dcalde11/EGR314DonDataSheet/docs/index.md

---
title: Welcome
tags:
- tag1
- tag2
---
<center>
<font size= "6">Donovan Calderon Datasheet</font><br>
as part of<br>
<font size= "8"> Submersible Exploration Device </font><br>
for<br>
<font size= "5"> Team 307 </font><br>

**Submission: March, 15, 2026**
</center>

## Introduction
As a member of Team 307, my responsibility was to help 
ensure the team remained on schedule while maintaining a 
professional standard for quality and performance. I 
supported teammates in the development of their modules 
according to project requirements while also assisting in 
prioritizing critical tasks when deadlines approached.

These responsibilities sometimes required difficult 
decisions, including adjusting timelines to preserve the 
integrity of both the project and our work. In addition 
to these leadership duties, my primary technical focus 
was the development of the 3D orientation and positioning 
subsystem.

This page documents my contributions to the electrical 
design, system integration, and performance of the final 
project.

### Project Summary

The concept of a Submersible Exploration Device that the
team came up is to support safe and efficient
underwater exploration through controlled navigation, 
environmental sensing, and real-time system monitoring. 
The overall system integrates pressure and temperature 
sensors for environmental data collection, obstacle
detection for safe movement, and a modular human–machine 
interface that allows operators to monitor system
performance and interact with the device during operation.

My contribution to this project focused on the 
development and integration of the electrical systems 
that support the device’s operation, including the 
implementation of the 3D orientation and positioning 
subsystem. This work involved ensuring reliable 
communication between sensors, microcontrollers, and 
hardware while maintaining stable power distribution 
throughout the system. However my contribution extends 
further into the development of the Navigation system 
using the concept of bevel gears for the mounting of the 
motor controlling the propulsion, as well as the 
developemnt of ALL code across all subsystems.
Below are a few links that highlight my contributions
within the Team Website as well as my Teammates websites 

## Project Links Within Team-Website

- [Sequence Diagram of Team Communication](https://egr-314-team-307-spring-2026.github.io/Team307.github.io/04-Team-Block-Diagram/Team-Diagram/)

- [Chosen Design](https://egr-314-team-307-spring-2026.github.io/Team307.github.io/02-Concept-Design/Design/)

### Direct Links
Here are links across my website that help you navigate 
to specific areas of interest that supported the development 
of my 3D Orientation and Positioning Subsystem.

* To review the details and relationships between the system’s components, refer to the [Block Diagram](https://dcalde11.github.io/EGR314DonDataSheet/02-Block-Diagram/Block-Diagram/).

* To review the system’s components, refer to the [Component Selection](https://dcalde11.github.io/EGR314DonDataSheet/03-Component-Selection/Component-Selection/).

* To review the firmware implementation, refer to the [Microcontroller Code](https://dcalde11.github.io/EGR314DonDataSheet/08-MircoController/MicroController/).

* To review the system communication protocol, refer to the [API Documentation](https://dcalde11.github.io/EGR314DonDataSheet/09-API/API/).

* To review power distribution, refer to the [Power Budget](https://dcalde11.github.io/EGR314DonDataSheet/07-Power%20Budget/powerbudget/).

* To review the cost of components in the subsystem, refer to the [Bill of Materials](https://dcalde11.github.io/EGR314DonDataSheet/04-BOM/BOM/).

* To review the layout of the subsystem, refer to the [Schematic](https://dcalde11.github.io/EGR314DonDataSheet/05-Schematic/schematic/).

* To review the physical PCB layout, refer to the [PCB Design](https://dcalde11.github.io/EGR314DonDataSheet/06-PCB/pcb/).

* To review system requirements, refer to the [Requirements](https://dcalde11.github.io/EGR314DonDataSheet/01-Requirements/Requirements/).

* To review hardware revisions and updates, refer to the [Hardware V2.0](https://dcalde11.github.io/EGR314DonDataSheet/10-Hardware%20V2.0/hardware/).

* To review supporting files and documentation, refer to the [Resources](https://dcalde11.github.io/EGR314DonDataSheet/11-Resources/resources/).

* To review final analysis and project conclusions, refer to the [Reflection](https://dcalde11.github.io/EGR314DonDataSheet/12-Reflection/reflection/).
