dcalde11/EGR314DonDataSheet/docs/10- Hardware V2.0/hardware.md

---
title: Hardware V2.0
tags:
- tag1
- tag2
---
# Hardware V2.0

## Overview
The current Hall Effect Sensor PCB successfully demonstrates the basic functionality including sensor reading, UART communication, and system monitoring using the ESP32-S3. While the 
design works, testing and implementation showed several areas where the hardware could be improved. A Version 2.0 (V2.0) design would focus on making the system more reliable, easier to 
debug, and be better aligned with the original schematic.

## Power System

The current design steps down a +12V input to +5V and +3.3V for the system. While it works, the design could be improved by adding better filtering and protection.

For V2.0:
- Add input protection (reverse polarity protection)
- Improve capacitor placement for cleaner power
- Add more decoupling near sensors and the microcontroller

The changes would reduce electrical noise and improve overall system stability.

## I²C Communication

The original schematic includes two I²C buses, but the current model only uses one.

For V2.0:
- Fully implement both I²C buses
- Ensure proper pull-up resistors are used
- Improve routing of I²C lines on the PCB

Using two buses would make the system more reliable and allow better separation between different sensor functions.

## Sensor Interface

The Hall effect sensor currently works, but it is connected with minimal filtering.

For V2.0:
- Add small filtering components (like capacitors)
- Place components closer to the sensor

This would improve the accuracy and stability of the sensor readings.

## UART Communication

UART is used for communication between systems, but the support is minimal.

For V2.0:
- Add protection on UART lines
- Include a dedicated header for debugging
- Improve accessibility for testing signals

This would make communication more reliable and easier to troubleshoot.

## Servo Support

The PCB includes support for servo control, but the feature was not fully used in the current model.

For V2.0:
- Improve power routing for servo connections
- Add better support for PWM signals
- Separate servo power from logic power if needed

This would allow the system to safely handle higher current loads from motors.

## Debugging Features

The current board includes LEDs for status indication, which are useful during testing.

For V2.0:
- Add more labeled test points
- Improve labeling on the PCB (silkscreen)
- Include easier access to important signals

This would make debugging faster and more efficient.

## PCB Layout

The current PCB works, but the layout can be improved.

For V2.0:
- Improve ground connections
- Clean up routing of signals
- Use wider traces for power lines

Better layout would improve reliability and reduce noise in the system.

## Conclusion

The Version 1.0 design provides a working foundation for the Hall effect sensor system. However, a V2.0 version would improve reliability, signal quality, and usability. By improving the
power system, communication interfaces, and PCB layout, the next version of the hardware would be more robust and easier to use in a complete system.
