dcalde11/EGR314DonDataSheet/docs/05-Schematic/schematic.md

---
title: Module Schematic
---

## Overview

The schematic supports the module’s functionality, power distribution, and 
microcontroller integration. It shows the connections between the major 
components: the AS5600L-ASOM and AS5600-ASOM Hall effect sensors, the ESP32-
S3-WROOM-N4 microcontroller, the TLV73312PDBVR and TPS565242DRLR voltage 
regulators, the 1142 RC servo motors, and the LTST-C190GKT LEDs.

The design ensures:  
- Stable and regulated power delivery  
- Reliable signal conditioning  
- Correct microcontroller interfacing  
- System protection and filtering where required

- **Schematic Image Preview:**  
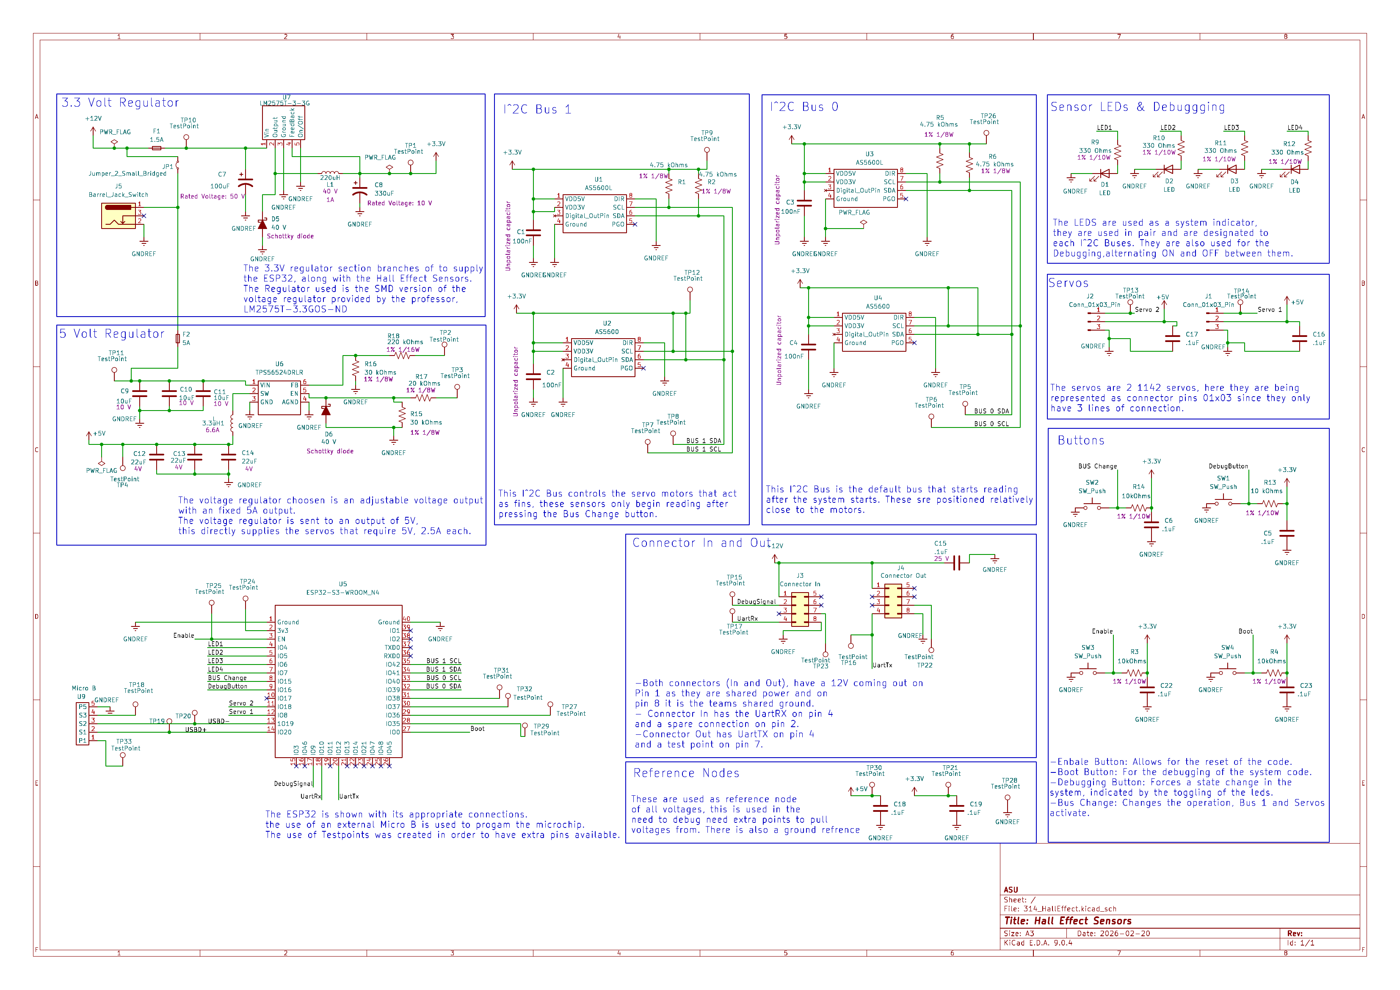
[picture p1: docs/05-Schematic/hall_effect_page_1.png]
Schematic Final
  

**Figure 1:** schematic of the Hall Effect module.

---

## Resources

- **Schematic PDF:** [View 314_HallEffect.pdf](https://github.com/dcalde11/EGR314DonDataSheet/raw/6f55fc1257101241bbe329a0fdce8a7df8599664/docs/05-Schematic/314_HallEffect.pdf)  
- **Complete Project ZIP:** [Download Final314HallEffect.zip](https://github.com/dcalde11/EGR314DonDataSheet/raw/6f55fc1257101241bbe329a0fdce8a7df8599664/docs/05-Schematic/FInal314HallEffect.zip)
