dcalde11/EGR314DonDataSheet/docs/11-Resources/resources.md

---
title: Resources
tags:
- tag1
- tag2
---

# Resources

## Overview

This section contains all supporting files for the project, including firmware, CAD models, and downloadable archives. 

---

## Firmware / Code

**ESP32 / MicroPython Code:**  
  [Download Basic UART Code](https://raw.githubusercontent.com/dcalde11/EGR314DonDataSheet/4a1f67aaadf7519277476e082b6c2123e0716abe/docs/09-API/BasicCodewithUart.py)

---

## CAD / Mechanical Design Files

The following SolidWorks parts and drawings were used in the mechanical design of the system:

- [Body.SLDPRT](https://github.com/dcalde11/EGR314DonDataSheet/blob/a26ca262ecb304e450433a2384b6ee27ddb0144a/docs/11-Resources/Body.SLDPRT)  
- [BodyDrawing.SLDDRW](https://github.com/dcalde11/EGR314DonDataSheet/blob/a26ca262ecb304e450433a2384b6ee27ddb0144a/docs/11-Resources/BodyDrawing.SLDDRW)  
- [Bodyv2sub.SLDPRT](https://github.com/dcalde11/EGR314DonDataSheet/blob/a26ca262ecb304e450433a2384b6ee27ddb0144a/docs/11-Resources/Bodyv2sub.SLDPRT)  
- [HeadFace.SLDPRT](https://github.com/dcalde11/EGR314DonDataSheet/blob/a26ca262ecb304e450433a2384b6ee27ddb0144a/docs/11-Resources/HeadFace.SLDPRT)  
- [Manta.SLDPRT](https://github.com/dcalde11/EGR314DonDataSheet/blob/a26ca262ecb304e450433a2384b6ee27ddb0144a/docs/11-Resources/Manta.SLDPRT)  
- [Part3.SLDPRT](https://github.com/dcalde11/EGR314DonDataSheet/blob/a26ca262ecb304e450433a2384b6ee27ddb0144a/docs/11-Resources/Part3.SLDPRT)  
- [bodypart2.SLDPRT](https://github.com/dcalde11/EGR314DonDataSheet/blob/a26ca262ecb304e450433a2384b6ee27ddb0144a/docs/11-Resources/bodypart2.SLDPRT)  

---

## Downloadable ZIP Files

- [BulletBillFullFiles.zip](https://github.com/dcalde11/EGR314DonDataSheet/blob/a26ca262ecb304e450433a2384b6ee27ddb0144a/docs/11-Resources/BulletBillFullFiles.zip)  
- [Spiral Bevel Gear Toy Set](https://github.com/dcalde11/EGR314DonDataSheet/blob/a26ca262ecb304e450433a2384b6ee27ddb0144a/docs/11-Resources/Spiral%20Bevel%20Gear%20Toy%20Set%20-%20961943.zip)
