dcalde11/EGR314DonDataSheet/docs/07-Power Budget/BPOWER (1).pdf

Team Number: | 307
Project Name: | 3D POSTIONMENT
Team Member Names: | Garret, Jt, Abriana,Lis,Zane
Version: | Donovan Calderon
All Major Components Component Name Part Number Supply Voltage Range # Absolute Maximum Current (mA) | Total Current (mA) | Unit
ESP32-S3-WROOM-1-N4 ESP32-S3-WROOM-1-N4 +3 - 3.6V 1 400 AS5600L AS5600L-ASOM SOIC8 +3 - 3.3V 2 6 AS5600 AS5600-ASOM SOIC8 +3 - 3.3V 2 6 Servo Motor MG995 +5 - 6V 2 2500 LEDs LTST-C150KT -5V - +2.1V 4 20 0 | 400 12 12 5000 80 0 | mA mA mA mA mA mA
+5V Power Rail Component Name Part Number Supply Voltage Range # Absolute Maximum Current (mA) | Total Current (mA) | Unit
Servo Motors MG995 5 - 6V 2 2000 Subtotal Safety Margin Total Current Required on +5V Rail c2. Regulator or Source Choice +5V Regulator TPS56524DRLR 5V 1 5000 Total Remaining Current Available on +5V Rail | 4000 0 mA 0 mA 0 mA 0 mA 4000 mA 25% 5000 mA 5000 0 mA | mA mA
+3.3V Power Rail Component Name Part Number Supply Voltage Range # Absolute Maximum Current (mA) | Total | Unit
Esp32-S3 ESP32-S3-WROOM-1-N4 +1.8 - 3.3V 1 375 AS5600 AS5600-ASOM SOIC8 +3 - 3.3V 2 6 AS5600L AS5600L-ASOM SOIC8 +3 - 3.3V 2 6 LEDs LTST-C150KT +2 - 2.2V 4 10 Subtotal Safety Margin Total Current Required on +3.3V Rail c4. Regulator or Source Choice +3.3V low-dropout regulatorLM2575T-3.3G +5V - 20V 1 1000 Total Remaining Current Available on 3.3V Rail | 375 12 12 40 439 mA 25% 548.75 mA 1000 451.25 mA | mA mA mA mA mA
External Power Source 1 Component Name Part Number Supply Voltage Range Outpu Absolute Maximum Current (mA) | Total | Unit
Power Source 1 Selection Plug-in Wall Supply GSD-120500 240VAC 12 5000 Power Rails Connected to +5V Regulator TPS56524DRLR +3 - 16V 5 5000 External Power Source 1 +3.3V low-dropout regulatorLM2575T-3.3G +4.75V - 40V 3.3 1000 Total Remaining Current Available on External Power Source 1 | 60000 0 mA 25000 3300 31700 mA | mA mA mA
D. Select a specific external power source (wall supply or battery) for your system, and confirm that it can supply all of the regulators for all of the power rails simultaneously. If

# Power Budget Example

A. List ALL major components (active devices, integrated circuits, etc.) except for power sources, voltage regulators, resistors, capacitors, or passive elements
