dcalde11/EGR314DonDataSheet/docs/06-PCB/DFM analysis report_JLCDFM_GerberFiles314.zip.pdf

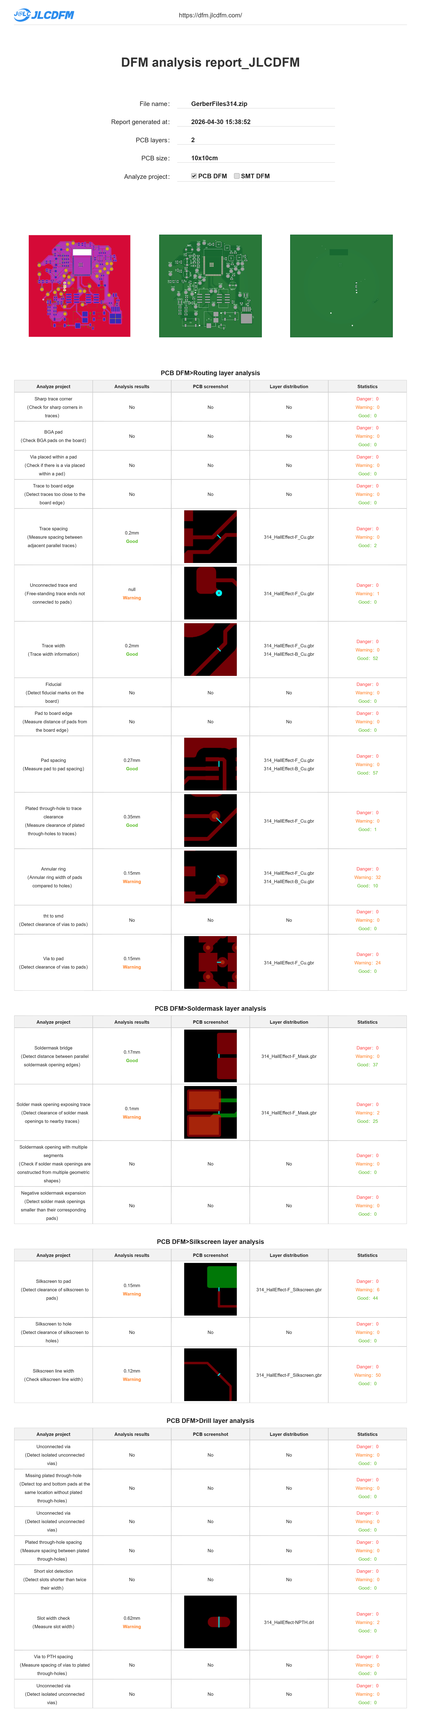
[picture p8: page 1]
