dcalde11/EGR314DonDataSheet/docs/08-MircoController/PINSS.png

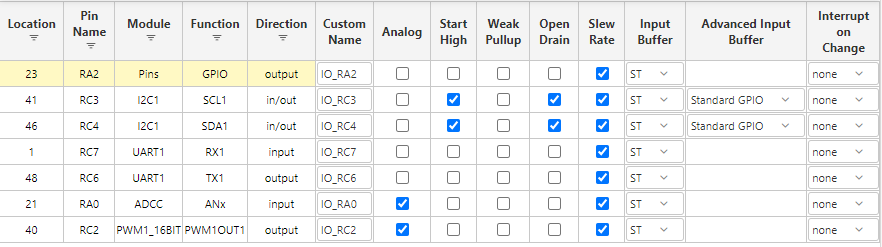
docs/08-MircoController/PINSS.png
