dcalde11/EGR314DonDataSheet/docs/08-MircoController/PINSSV2.png

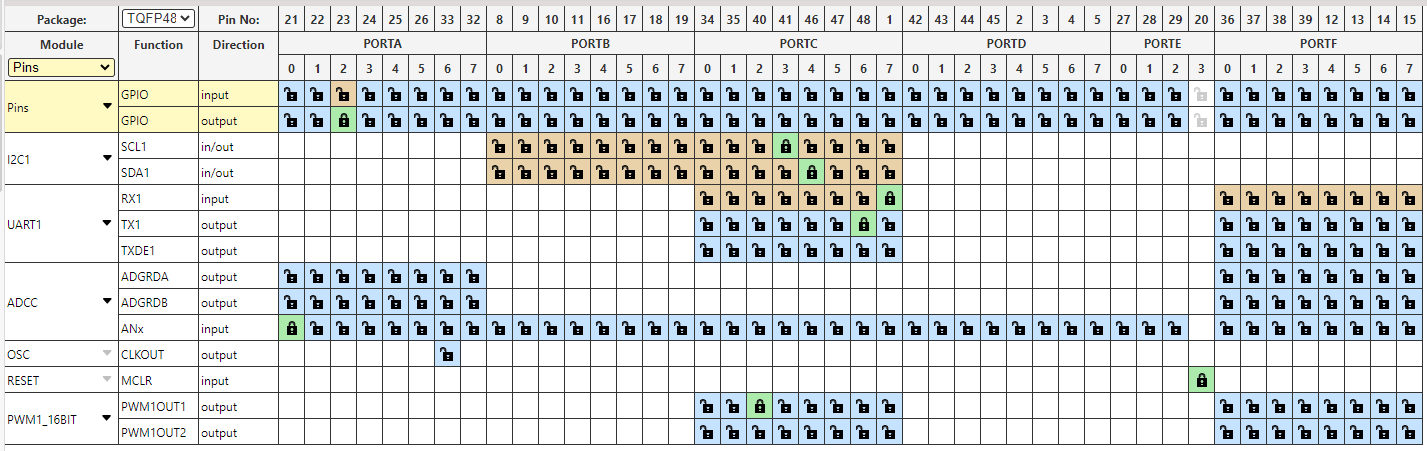
docs/08-MircoController/PINSSV2.png
