dcalde11/EGR314DonDataSheet/docs/04-BOM/Bill of MATERIALS FINAL.xlsx

Bill Of Materials: 3D Positioning
Part Name/Description | Unit Quantity | Unit Prototype Cost | Total Prototype Cost | Unit Production Cost | Total Production Cost | Manufacturer | Manufacturer Part # | Vendor Link | Datasheet Link | Supplier | Supplier Part # | # Ordered | Date Ordered | # Received | Surplus | Schematic Reference Designators
Inductor 3.3uH | 1 | $3.15 | $3.15 | $3.15 | $3.15 | Coilcraft | XAL4030-332MEC | Digikey (https://www.digikey.com/en/products/detail/coilcraft/XAL4030-332MEC/21381756) | Datasheet Link (https://www.coilcraft.com/getmedia/6adcb47d-8b55-416c-976e-1e22e0d2848c/xal4000.pdf) | DigiKey | 2457-XAL4030-332MEC-ND | 3 | 2026-03-06 | 0 | -1 | L
100nf (0.1 µF) Ceramic Capacitor, +/-10%, X7R, 50V, 0805 package | 4 | $0.10 | $0.40 | $0.10 | $0.40 | Samsung Electro-Mechanics | CL21F104ZAANNNC | DigiKey (https://www.digikey.com/en/products/detail/samsung-electro-mechanics/CL21F104ZAANNNC/3886944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) | Datasheet Link (https://weblib.samsungsem.com/mlcc/mlcc-ec-data-sheet.do?partNumber=CL05Y105KP6VPN) | DigiKey | 1276-1286-2-ND | 5 | 2026-03-06 | 0 | -4 | C1,C2,C3,C4
0.1 µF Ceramic Capacitor, +/-10%, X7R, 50V, 0805 package | 5 | $0.10 | $0.50 | $0.10 | $0.50 | Samsung Electro-Mechanics | CL21F104ZAANNNC | DigiKey (https://www.digikey.com/en/products/detail/samsung-electro-mechanics/CL21F104ZAANNNC/3886944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) | Datasheet Link (https://weblib.samsungsem.com/mlcc/mlcc-ec-data-sheet.do?partNumber=CL05Y105KP6VPN) | DigiKey | 1276-1286-2-ND | 5 | 2026-03-06 | 0 | -5 | C5,C6C15
100uF 50 V Aluminum Electrolytic Capacitor | 1 | $0.75 | $0.75 | $0.75 | $0.75 | Panasonic Electronic Components | EEE-HA1H101P | DigiKey (https://www.digikey.com/en/products/detail/panasonic-electronic-components/EEE-HA1H101P/814182) | Datasheet Link (https://industrial.panasonic.com/cdbs/www-data/pdf/RDE0000/ABA0000C1151.pdf) | DigiKey | PCE4210TR-ND | 3 | 2026-03-06 | 0 | -1 | C7
330uF 10 V Aluminum Electrolytic Capacitor | 1 | $0.66 | $0.66 | $0.66 | $0.66 | Panasonic Electronic Components | EEE-1AA331P | DigiKey (https://www.digikey.com/en/products/detail/panasonic-electronic-components/EEE-1AA331P/766041) | Datasheet Link (https://mm.digikey.com/Volume0/opasdata/d220001/medias/docus/2172/S_Series%2CType_V_Rev2018.pdf) | DigiKey | PCE3874TR-ND | 3 | 2026-03-06 | 0 | -1 | C8
10uF 10V Ceramic Capacitors | 3 | $0.08 | $0.24 | $0.08 | $0.24 | Taiyo Yuden | LMK212BJ106KG-T | DigiKey (https://www.digikey.com/en/products/detail/taiyo-yuden/LMK212BJ106KG-T/930652) | Datasheet Link (https://mm.digikey.com/Volume0/opasdata/d220001/medias/docus/8412/MLCCTYdownload.pdf) | DigiKey | 587-1300-2-ND | 5 | 2026-03-06 | 0 | -3 | C9,C10,C11
22uF 4 Volts Ceramic Capacitor | 3 | $0.12 | $0.36 | $0.12 | $0.36 | Murata Electronics | GRM188R60G226MEA0D | DigiKey (https://www.digikey.com/en/products/detail/murata-electronics/GRM188R60G226MEA0D/2334877) | Datasheet Link (https://search.murata.co.jp/Ceramy/image/img/A01X/G101/ENG/GRM188R60G226MEA0-01.pdf) | DigiKey | 490-5526-2-ND | 6 | 2026-03-06 | 0 | -3 | C12,C13,C14
Green LEDs, LTST-C150GKT | 4 | $0.15 | $0.60 | $0.15 | $0.60 | Lite-On Inc. | LTST-C150GKT | DigiKey (https://www.digikey.com/en/products/detail/liteon/LTST-C150GKT/269216) | Datasheet Link (https://optoelectronics.liteon.com/upload/download/DS-22-98-0004/LTST-C150GKT.pdf) | DigiKey | 160-1169-2-ND | 8 | 2026-03-06 | 0 | -4 | D1,D2,D3,D4
Schotty Diode | 2 | $0.10 | $0.20 | $0.10 | $0.20 | Vishay General Semiconductor - Diodes Division | MSS1P4-M3/89A | DigiKey (https://www.digikey.com/en/products/detail/vishay-general-semiconductor-diodes-division/MSS1P4-M3-89A/2071753) | Datasheet Link (https://www.vishay.com/docs/89019/mss1p4.pdf) | DigiKey | MSS1P4-M3/89AGITR-ND | 4 | 2026-03-06 | 0 | -2 | D5,D6
Fuse Holder | 2 | $1.25 | $2.50 | $1.25 | $2.50 | Keystone Electronics | 3588 | DigiKey (https://www.digikey.com/en/products/detail/keystone-electronics/3588/2137308) | Datasheet Link (https://www.keyelco.com/userAssets/file/K75p49.pdf) | DigiKey | 36-3588-ND | 4 | 2026-03-06 | 0 | -2 | F1
Servos (1142) | 2 | $19.95 | $39.90 | $19.95 | $39.90 | Adafruit Industries LLC | 1142 | DigiKey (https://www.digikey.com/en/products/detail/adafruit-industries-llc/1142/5154658?s=N4IgTCBcDaILIHECcSCsIC6BfIA) | Datasheet Link (https://mm.digikey.com/Volume0/opasdata/d220001/medias/docus/2203/1142_Web.pdf) | DigiKey | 1528-1083-ND | 4 | 2026-03-06 | 0 | -2 | J1,J2
Conn_02x04_Pin | 2 | $0.00 | $0.00 | $0.00 | $0.00 | PRLTA 110 | PRLTA 109 | PRLTA 109 (https://www.digikey.com/en/products/detail/same-sky-formerly-cui-devices-/TS02-66-55-BK-160-LCR-D/15634374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) | Datasheet Link (https://www.sameskydevices.com/product/resource/ts02.pdf) | PRLTA 109 | PRLTA 109 | 4 | 2026-03-06 | 0 | -2 | J3,J4
Inductor 220uH | 1 | $0.90 | $0.90 | $0.90 | $0.90 | Eaton - Electronics Division | DR124-221-R | DigiKey (https://www.digikey.com/en/products/detail/eaton-electronics-division/DR124-221-R/1555470) | Datasheet Link (https://www.eaton.com/content/dam/eaton/products/electronic-components/resources/data-sheet/eaton-dr124-shielded-drum-core-power-inductors-data-sheet.pdf) | DigiKey | 283-DR124-221-RTR-ND | 3 | 2026-03-06 | 0 | -1 | L1
4.75 kOhms 0.125W, 1/8W Resistor 0805 | 8 | $0.00 | $0.00 | $0.00 | $0.00 | PRLTA 109 | PRLTA 109 | DigiKey (https://www.digikey.com/en/products/detail/meritek/CR104751F/13408826) | Datasheet Link (https://www.meritekusa.com/wp-content/uploads/2018/06/Standard-Chip-Resistor-CR-Series.pdf) | PRLTA 109 | PRLTA 109 | 10 | 2026-03-06 | 0 | -8 | R1,R2,R3,R4,R5,R6,R7,R8
330 Ohms 0.1W 1/10w Resistor 0805 | 4 | $0.10 | $0.40 | $0.10 | $0.40 | PRLTA 109 | PRLTA 109 | DigiKey (https://www.digikey.com/en/products/detail/koa-speer-electronics-inc/RK73H1ETTP3300F/9844096) | Datasheet Link (https://www.koaspeer.com/pdfs/RK73H.pdf) | PRLTA 109 | PRLTA 109 | 10 | 2026-03-06 | 0 | -4 | R9,R10,R11,R12
10 kOhm 1/10W Resistor 0805 | 2 | $0.10 | $0.20 | $0.10 | $0.20 | PRLTA 109 | PRLTA 109 | DigiKey (https://www.digikey.com/en/products/detail/koa-speer-electronics-inc/RK73H1JTTD1002F/9844954) | Datasheet Link (https://www.koaspeer.com/pdfs/RK73H.pdf) | PRLTA 109 | PRLTA 109 | 10 | 2026-03-06 | 0 | -2 | R13,R14
30 kOhms 1/8W Resistor 0805 | 2 | $0.10 | $0.20 | $0.20 | $0.40 | PRLTA 109 | PRLTA 109 | DigiKey (https://www.digikey.com/en/products/detail/stackpole-electronics-inc/RMCF0805FT30K0/1760543) | Datasheet Link (https://www.digikey.com/en/products/detail/stackpole-electronics-inc/RMCF0805FT30K0/1760543) | PRLTA 109 | PRLTA 109 | 10 | 2026-03-06 | 0 | -2 | R15,16
20 kOhms 1/16W Resistor 0805 | 1 | $0.10 | $0.10 | $0.20 | $0.20 | PRLTA 109 | PRLTA 109 | DigiKey (https://www.digikey.com/en/products/detail/yageo/RC0402FR-0720KL/726557) | Datasheet Link (https://yageogroup.com/content/datasheet/asset/file/PYU-RC_GROUP_51_ROHS_L) | PRLTA 109 | PRLTA 109 | 10 | 2026-03-06 | 0 | -1 | R17
220 kOhms 1/16W Resistor 0805 | 1 | $0.10 | $0.10 | $0.10 | $0.10 | PRLTA 109 | PRLTA 109 | DigiKey (https://www.digikey.com/en/products/detail/yageo/RC0402FR-07220KL/726564) | Datasheet Link (https://yageogroup.com/content/datasheet/asset/file/PYU-RC_GROUP_51_ROHS_L) | PRLTA 109 | PRLTA 109 | 10 | 2026-03-06 | 0 | -1 | R18
Switch Tactile 0.05A 12V | 2 | $0.27 | $0.54 | $0.27 | $0.54 | PRLTA 109 | PRLTA 109 | DigiKey (https://www.digikey.com/en/products/detail/c-k/PTS647SM38SMTR2-LFS/9649861) | Datasheet Link (https://www.ckswitches.com/media/2567/pts647.pdf) | PRLTA 109 | PRLTA 109 | 4 | 2026-03-06 | 0 | -2 | SW1,SW2
AS5600L Hall Effect | 2 | $3.20 | $6.40 | $3.20 | $6.40 | ams-OSRAM USA INC. | AS5600L-ASOM SOIC8 LF T&RDP | DigiKey (https://www.digikey.com/en/products/detail/ams-osram-usa-inc/AS5600L-ASOM-SOIC8-LF-T-RDP/10324317) | Datasheet Link (https://look.ams-osram.com/m/7059eac7531a86fd/original/AS5600-DS000365.pdf) | PRLTA 109 | PRLTA 109 | 3 | 2026-03-06 | 0 | -2 | U1,U3
AS5600 Hall Effect | 2 | $3.17 | $6.34 | $3.17 | $6.34 | ams-OSRAM USA INC. | AS5600-ASOM SOIC8 LF T&RDP | DigiKey (https://www.digikey.com/en/products/detail/ams-osram-usa-inc/AS5600-ASOM-SOIC8-LF-T-RDP/4914332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) | Datasheet Link (https://look.ams-osram.com/m/7059eac7531a86fd/original/AS5600-DS000365.pdf) | PRLTA 109 | PRLTA 109 | 3 | 2026-03-06 | 0 | -2 | U2,U4
Esp32-S3-Wroom-N4 | 1 | $5.06 | $5.06 | $5.06 | $5.06 | Espressif Systems | ESP32-S3-WROOM-1-N4 | Digikey (https://www.digikey.com/en/products/detail/espressif-systems/ESP32-S3-WROOM-1-N4/16162639) | Datasheet Link (https://documentation.espressif.com/esp32-s3-wroom-1_wroom-1u_datasheet_en.pdf) | PRLTA 109 | PRLTA 109 | 2 | 2026-03-06 | 0 | -1 | U5
TPS56524DRLR | 1 | $0.65 | $0.65 | $0.65 | $0.65 | Texas Instruments | TPS565242DRLR | DigiKey (https://www.digikey.com/en/products/detail/texas-instruments/TPS565242DRLR/16585745) | Datasheet Link (https://www.ti.com/lit/ds/symlink/tps565242.pdf) | DigiKey | 296-TPS565242DRLRTR-ND | 3 | 2026-03-06 | 0 | -1 | U6
LM2575T-3.3G | 1 | $2.51 | $2.51 | $2.51 | $2.51 | onsemi | LM2575T-3.3G | DigiKey (https://www.digikey.com/en/products/detail/onsemi/LM2575T-3-3G/1476700) | Datasheet Link (https://www.onsemi.com/pdf/datasheet/lm2575-d.pdf) | PRLTA 109 | PRLTA 109 | 3 | 2026-03-06 | 0 | -1 | U7
Barrel Jack Switch | 1 | $0.69 | $0.69 | $0.69 | $0.69 | Kycon, Inc. | KLDX-0202-A | DigiKey (https://www.digikey.com/en/products/detail/kycon-inc/KLDX-0202-A/9975992) | Datasheet Link (https://www.kycon.com/Catalog_PDF/KLDX_0202.pdf) | PRLTA 109 | 2092-KLDX-0202-A-ND | 2 | 2026-03-06 | 0 | -1 | U8
Micro-B USB Connector | 1 | $0.78 | $0.78 | $0.78 | $0.78 | GCT | USB3131-30-0230-A | DigiKey (https://www.digikey.com/en/products/detail/gct/USB3131-30-0230-A/9859642) | Datasheet Link (https://gct.co/files/specs/usb3131-spec.pdf) | PRLTA 109 | PRLTA 109 | 3 | 2026-03-06 | 0 | -1 | U9
Conn_0x02_Pin | 1 | $0.00 | $0.00 | $0.00 | $0.00 | PRLTA 109 | PRLTA 109 | Digikey (https://www.digikey.com/en/products/detail/samtec-inc/TS-132-T-A/1105462) | Datasheet Link (https://mm.digikey.com/Volume0/opasdata/d220001/medias/docus/6129/tx-1xx-x-x-mkt1.pdf) | PRLTA 109 | PRLTA 109 | 4 | 2026-03-11 | 0 | -1 | JP1
Test Points | 31 | $0.13 | $4.03 | $0.13 | $4.03 | KOA Speer Electronics, Inc. | RCWCTE | Digikey (https://www.digikey.com/en/products/detail/koa-speer-electronics-inc/RCWCTE/11476558) | Datasheet Link (https://www.koaspeer.com/pdfs/RC.pdf) | DigiKey | 2019-RCWCTETR-ND | 35 | 2026-03-11 | 0 | -31 | TP 1-31
