dcalde11/EGR314DonDataSheet/docs/11-Resources/bodypart2.SLDPRT

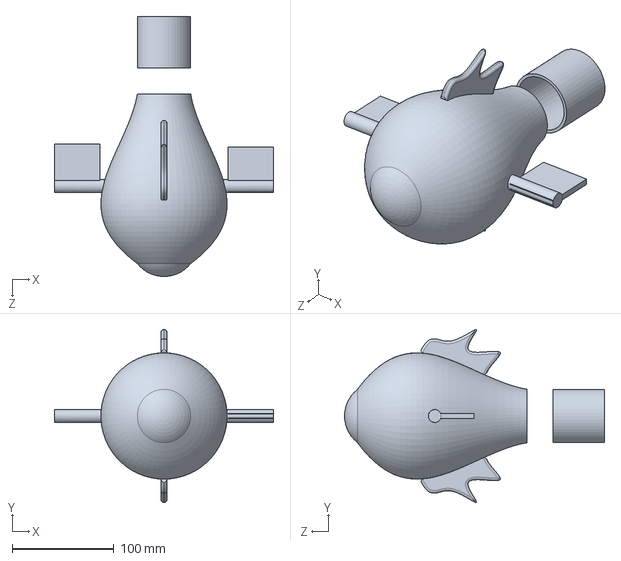
[picture p16: CAD file, 2026-05-05]
docs/11-Resources/bodypart2.SLDPRT
215.9 x 170.3 x 255.9 mm
