dcalde11/EGR314DonDataSheet/docs/11-Resources/Body.SLDPRT

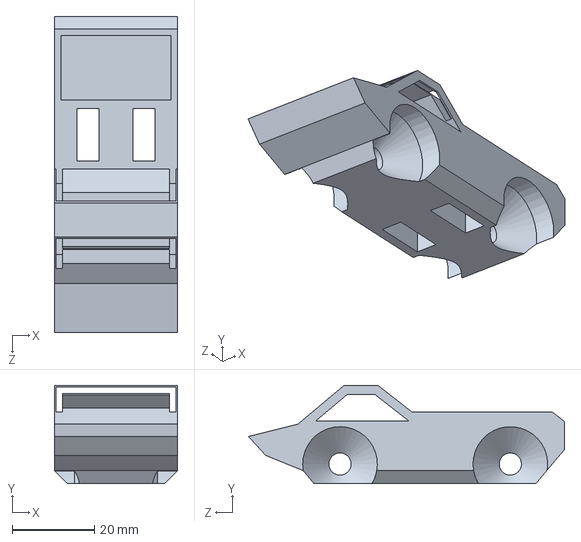
[picture p17: CAD file, 2026-05-05]
docs/11-Resources/Body.SLDPRT
30.0 x 24.0 x 77.0 mm
