dcalde11/EGR314DonDataSheet/docs/11-Resources/Bodyv2sub.SLDPRT

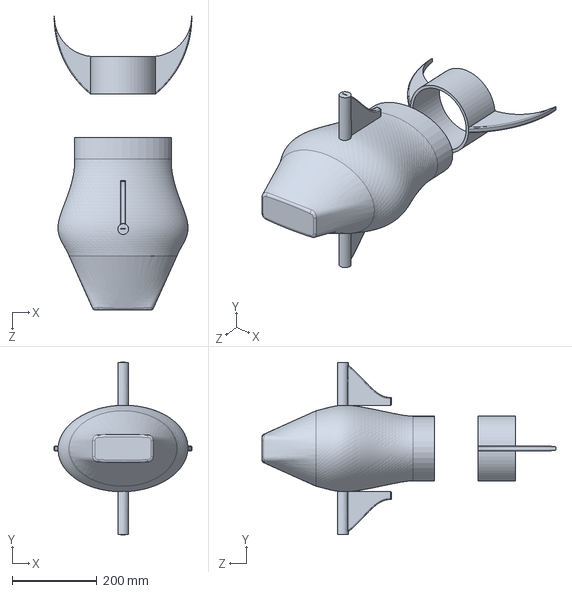
[picture p18: CAD file, 2026-05-05]
docs/11-Resources/Bodyv2sub.SLDPRT
323.7 x 406.4 x 691.9 mm
