dcalde11/EGR314DonDataSheet/docs/11-Resources/Manta.SLDPRT

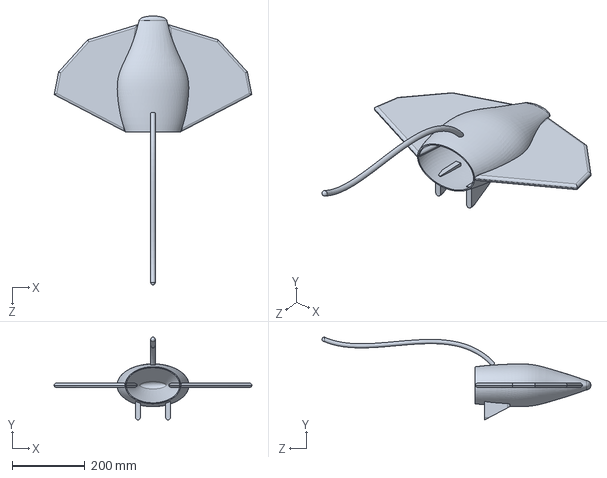
[picture p19: CAD file, 2026-05-05]
docs/11-Resources/Manta.SLDPRT
542.5 x 227.6 x 737.9 mm
