dcalde11/EGR314DonDataSheet/docs/11-Resources/HeadFace.SLDPRT

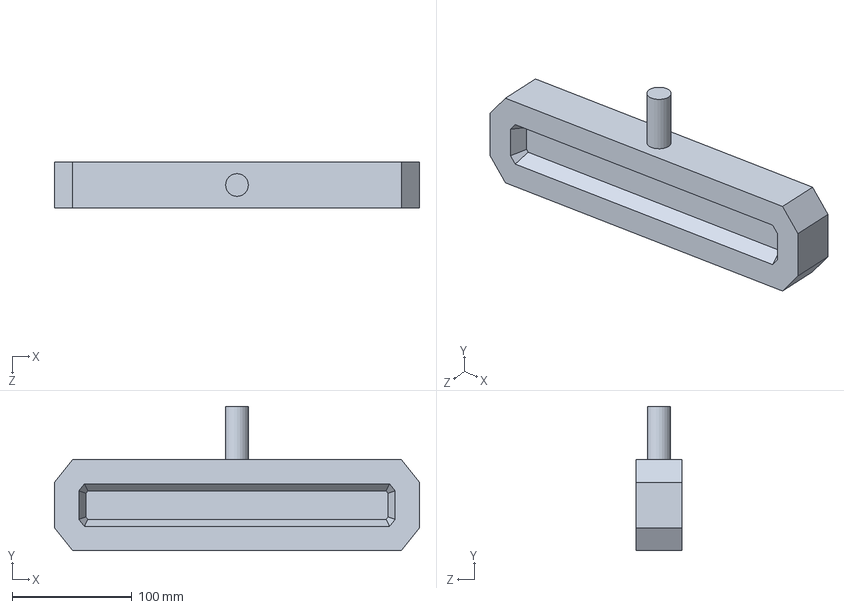
[picture p20: CAD file, 2026-05-05]
docs/11-Resources/HeadFace.SLDPRT
304.8 x 120.7 x 38.1 mm
