dcalde11/EGR314DonDataSheet/docs/11-Resources/Part3.SLDPRT

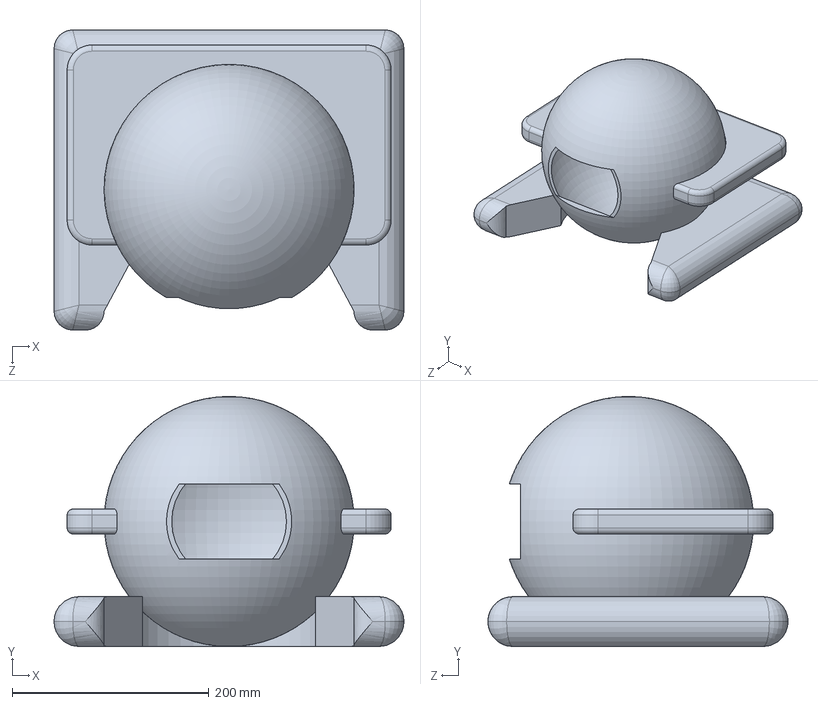
[picture p21: CAD file, 2026-05-05]
docs/11-Resources/Part3.SLDPRT
355.4 x 254.0 x 304.8 mm
