dcalde11/EGR314DonDataSheet/(list of files, cad)

Other CAD files:
docs/11-Resources/BodyDrawing.SLDDRW
