dcalde11/EGR314DonDataSheet/docs/05-Schematic/314_HallEffect.pdf

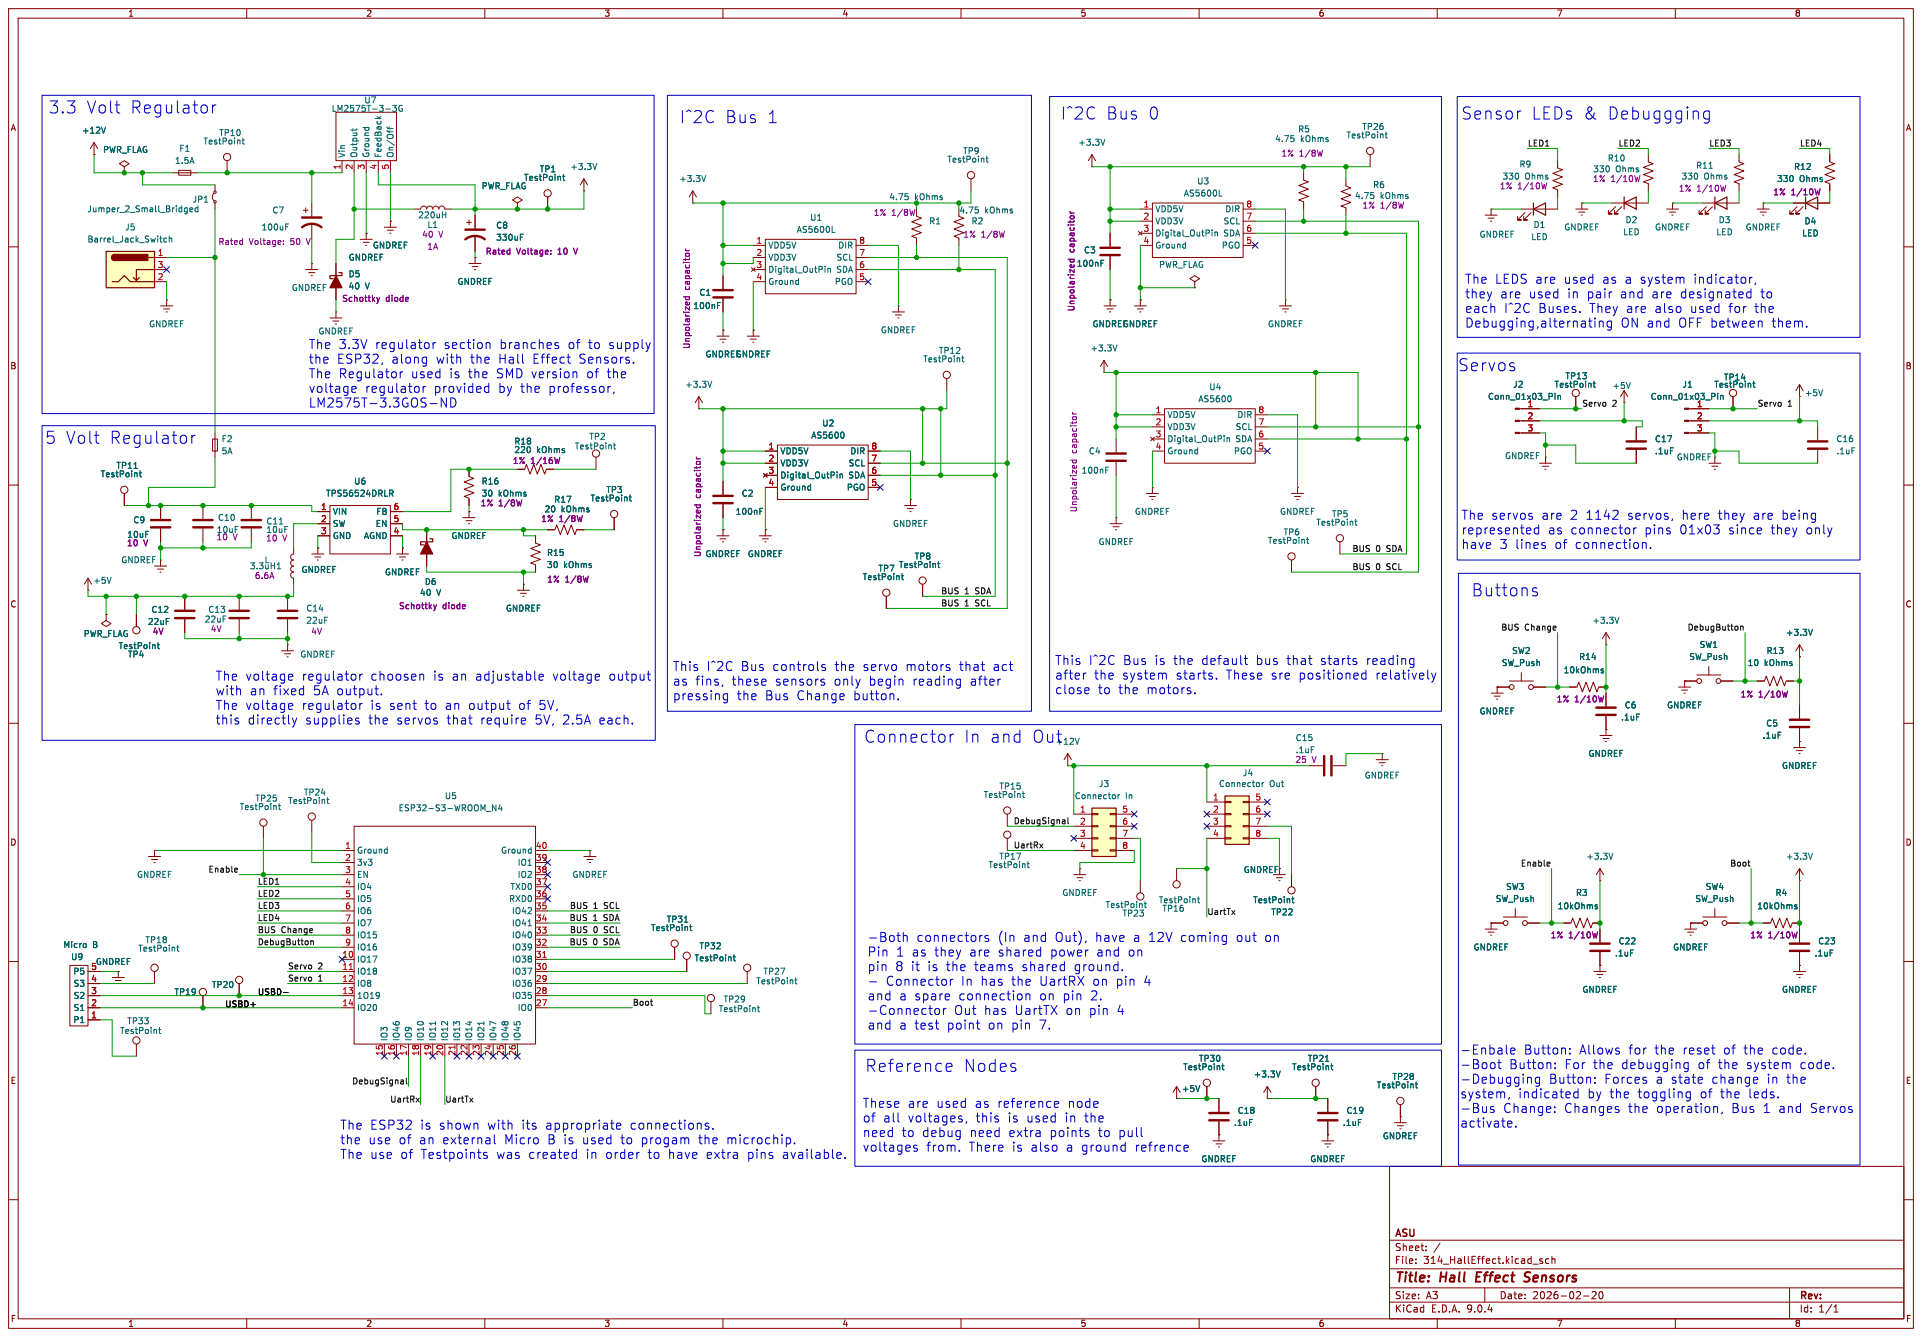
[picture p22: page 1]

The LEDS are used as a system indicator,
each I^2C Buses. They are also used for the
Servo 1 DebugButton

the ESP32, along with the Hall Effect Sensors.
LM2575T-3.3GOS-ND

The servos are 2 1142 servos, here they are being
have 3 lines of connection.

BUS 0 SCL BUS 1 SCL

This I^2C Bus is the default bus that starts reading
close to the motors.

with an fixed 5A output.

pressing the Bus Change button.

Connector In and Out

pin 8 it is the teams shared ground. - Connector In has the UartRX on pin 4

and a test point on pin 7.

These are used as reference node
of all voltages, this is used in the
need to debug need extra points to pull
voltages from. There is also a ground refrence

the use of an external Micro B is used to progam the microchip.
The use of Testpoints was created in order to have extra pins available.

Id: 1/1 Title: Hall Effect Sensors
