dcalde11/EGR314DonDataSheet/(commit log)

2026-01-15 Update BOM link in documentation
2026-01-15 Update Schematic link in documentation
2026-01-15 Replace links with placeholders in documentation
    Updated links to placeholders for power budget, PCB design, microcontroller code, and resources.
2026-01-18 Update team report link in project summary
    Updated project report link to reflect the current team report.
2026-02-01 Revise module requirements with detailed descriptions
    Updated the module requirements section to include detailed descriptions and specifications for each requirement, including power supply, microcontroller, communication, and sensor functionalities.
2026-02-05 Clean up formatting in Block Diagram documentation
    Removed formatting from voltage and communication descriptions for consistency.
2026-02-12 Revise component selection with additional links
    Updated component selection details and added links for resistors and capacitors.
2026-02-12 Refine component selection rationale and microcontroller choice
    Enhanced rationale for selected components, detailing integration benefits and performance characteristics. Updated pin assignments and final microcontroller choice rationale for clarity.
2026-02-12 Document PIC18F57Q43 configuration and selection
    Added detailed configuration and choice rationale for the PIC18F57Q43 microcontroller, including setup instructions and pin assignments.
2026-02-12 Update pin diagram image link in MicroController.md
2026-02-12 Add links to firmware and power budget documentation
2026-02-12 Fix placeholder links in documentation
    Updated links for Power Budget and Microcontroller Code.
2026-02-21 Update schematic image and fix formatting
2026-02-21 Update PDF link for schematic resource
2026-02-21 Update Zip folder link in schematic documentation
2026-02-21 Revise schematic overview and resource links
    Updated the schematic overview for clarity and added resource links.
2026-03-07 Update BOM PDF download link in documentation
2026-03-07 Revise BOM description and clean up formatting
    Updated the Bill of Materials (BOM) section with a grammatically cleaned description and removed unnecessary example notations.
2026-03-07 Add Power Budget image and PDF download link
2026-03-07 Revise Power Budget documentation with detailed descriptions
    Expanded the power budget section to include detailed descriptions of power requirements and components.
2026-03-07 Fix image tag formatting in schematic.md
2026-03-09 Add documentation for Hall Effect Sensor Control PCB
    This document describes the Hall Effect Sensor Control PCB, detailing its design, power system, communication buses, user interface elements, and debugging features.
2026-03-15 Update project documentation for clarity and detail
    Revised the introduction and project summary sections to clarify responsibilities and contributions to the Submersible Exploration Device project. Added links for further details on the 3D Orientation and Positioning Subsystem.
2026-03-15 Update documentation to remove placeholders and add PCB link
    Removed placeholder section and added PCB Design reference.
2026-03-15 Update power regulation options in documentation
2026-03-15 Enhance Component Selection documentation with images
    Updated component selection details and added images for Hall Effect Sensor and Voltage Regulator.
2026-03-15 Update component selection to include servos
2026-03-16 Update BOM section and resource links in documentation
2026-03-16 Update BOM description and component details
    Reformatted BOM description for clarity and added detailed component list.
2026-03-16 Update BOM resource section with Excel download
    Added Excel download option for the Bill of Materials.
2026-03-16 Enhance schematic overview and component details
    Updated schematic overview to include specific components and improved clarity.
2026-03-16 Revise PCB documentation for clarity and structure
    Updated the title and improved the structure of the PCB documentation. Enhanced clarity by reorganizing content and removing redundancy.
2026-03-16 Expand PCB documentation with resources and images
    Added PCB resources section with images and downloads.
2026-03-16 Document microcontroller pin connections and usage
    Added microcontroller pin connections and usage summary.
2026-03-16 Add detailed power budget information for 3D system
    Expanded the power budget section to detail current and power requirements for components, including safety margins and stability measures.
2026-03-16 Add Power Budget files section to documentation
    Added section for Power Budget files with image and PDF download links.
2026-03-16 Revise PCB documentation header and content
    Updated PCB documentation to include title and description.
2026-03-16 Add title and tags to powerbudget.md
    Added metadata including title and tags to the power budget document.
2026-03-16 Update image link for Power Budget section
2026-03-16 Improve formatting and readability of power budget section
    Reformatted text for better readability and fixed minor spacing issues.
2026-04-30 Update schematic image and resource links
2026-04-30 Update PCB documentation with additional resources
    Added images and links for 3D view, whole view, front view, back view, DFM analysis report, Gerber files, and final project package.
2026-04-30 Expand MicroController.md with firmware details
    Added detailed sections on firmware implementation, core communication system, sensor acquisition, LED status indication, message processing logic, system timing, and error handling behavior.
2026-04-30 Document firmware implementation and communication details
    Added detailed documentation for the firmware implementation, including UART communication, I²C sensor system, LED status indicators, and system behavior.
2026-05-05 Update hardware.md for Version 2.0 improvements
    Expanded the hardware documentation for Version 2.0, detailing improvements in power system, I²C communication, sensor interface, UART communication, servo support, debugging features, and PCB layout.
2026-05-05 Implement error indication for sensor issues
    Added error indication for sensor failures.
    [BasicCodewithUart.py]
2026-05-05 Add link to download Basic UART Code
